christm45/shc-onstepx-remote/img/connections_front.png

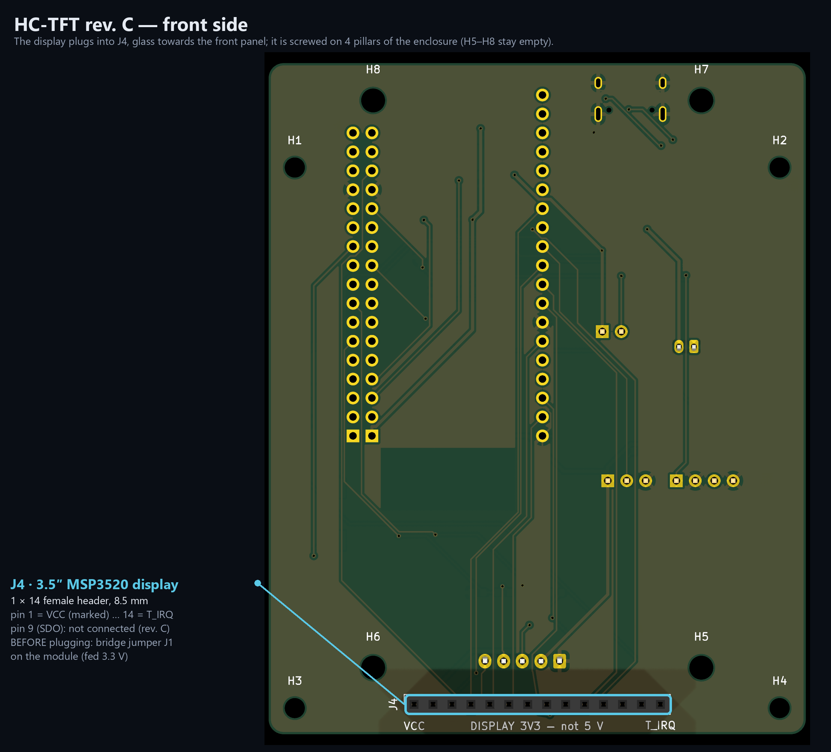
img/connections_front.png
