christm45/shc-onstepx-remote/img/enclosure/part_back_cover_inside.png

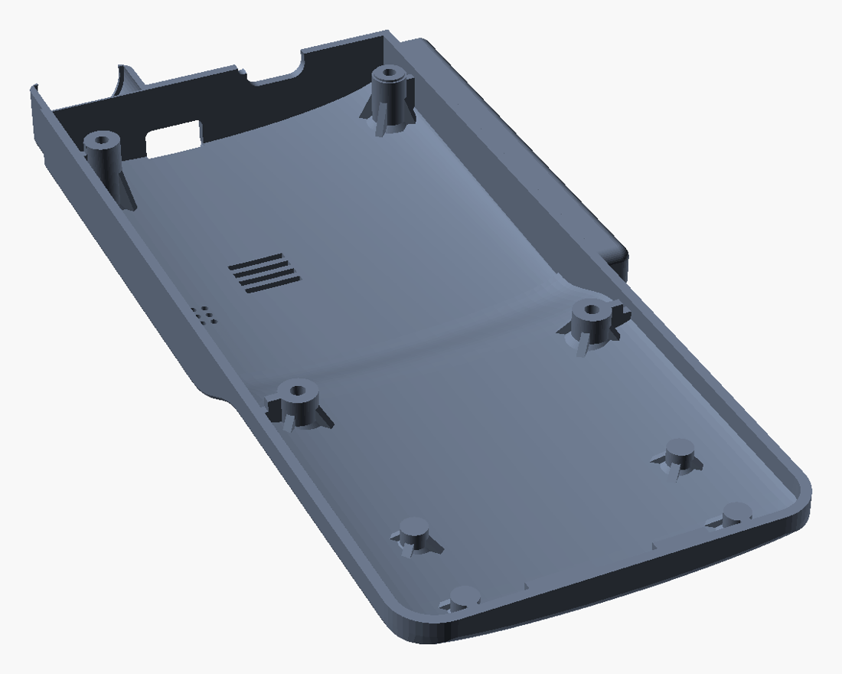
img/enclosure/part_back_cover_inside.png
