christm45/shc-onstepx-remote/img/enclosure/part_back_cover_outside.png

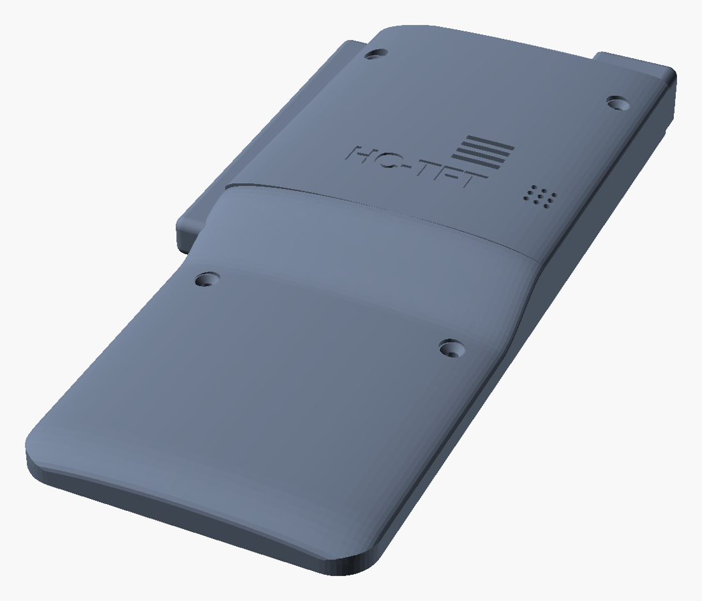
img/enclosure/part_back_cover_outside.png
