christm45/shc-onstepx-remote/img/enclosure/part_foot_pad_x2.png

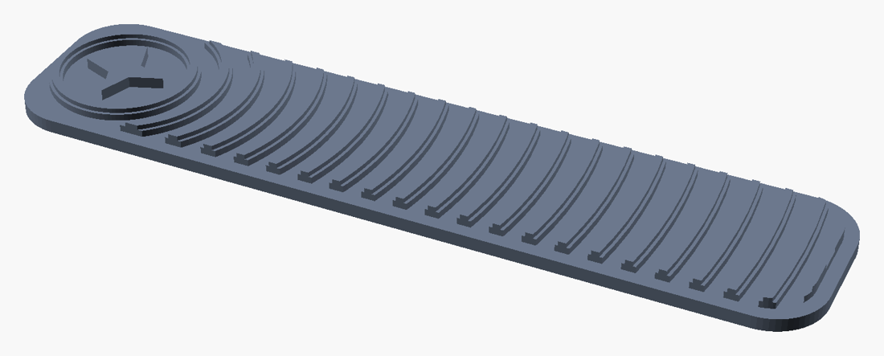
img/enclosure/part_foot_pad_x2.png
