christm45/shc-onstepx-remote/img/enclosure/part_front_inside.png

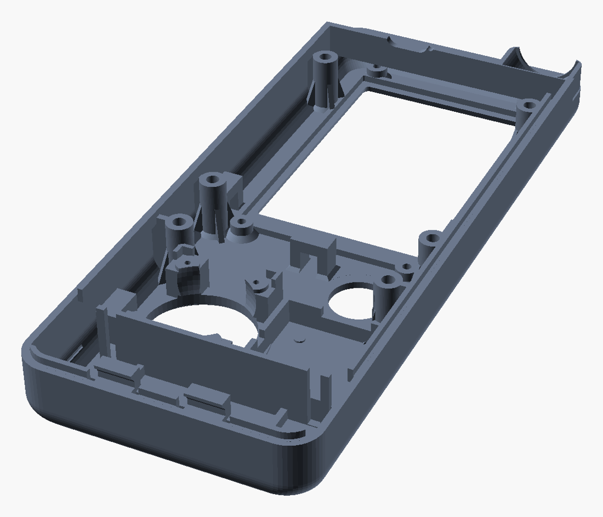
img/enclosure/part_front_inside.png
