christm45/shc-onstepx-remote/img/enclosure/part_front_outside.png

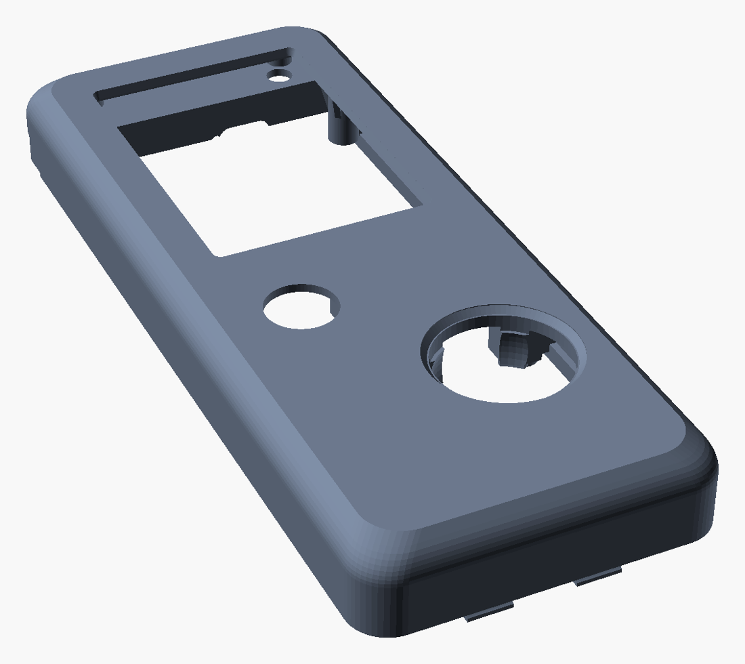
img/enclosure/part_front_outside.png
