christm45/shc-onstepx-remote/img/enclosure/part_joystick_cover.png

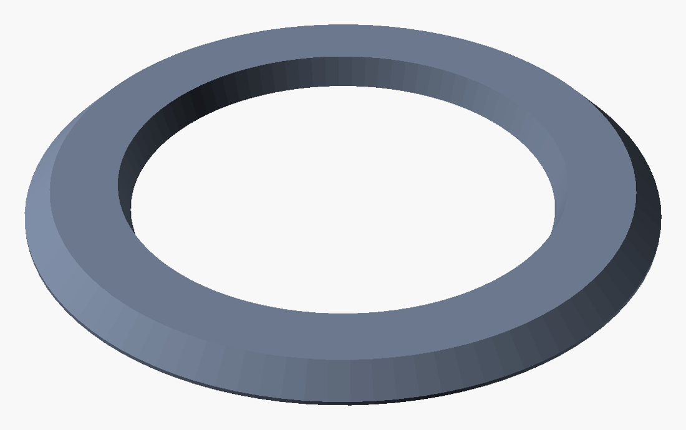
img/enclosure/part_joystick_cover.png
