christm45/shc-onstepx-remote/img/enclosure/part_joystick_template.png

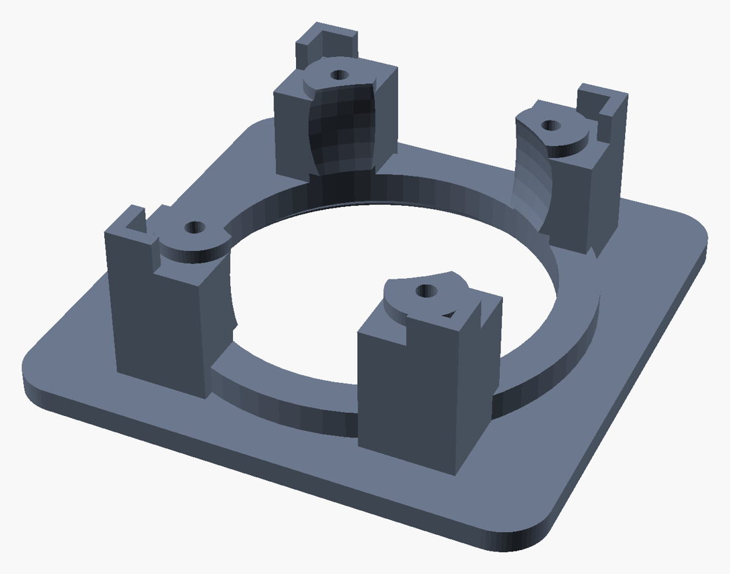
img/enclosure/part_joystick_template.png
