christm45/shc-onstepx-remote/img/pcb_smd_back.png

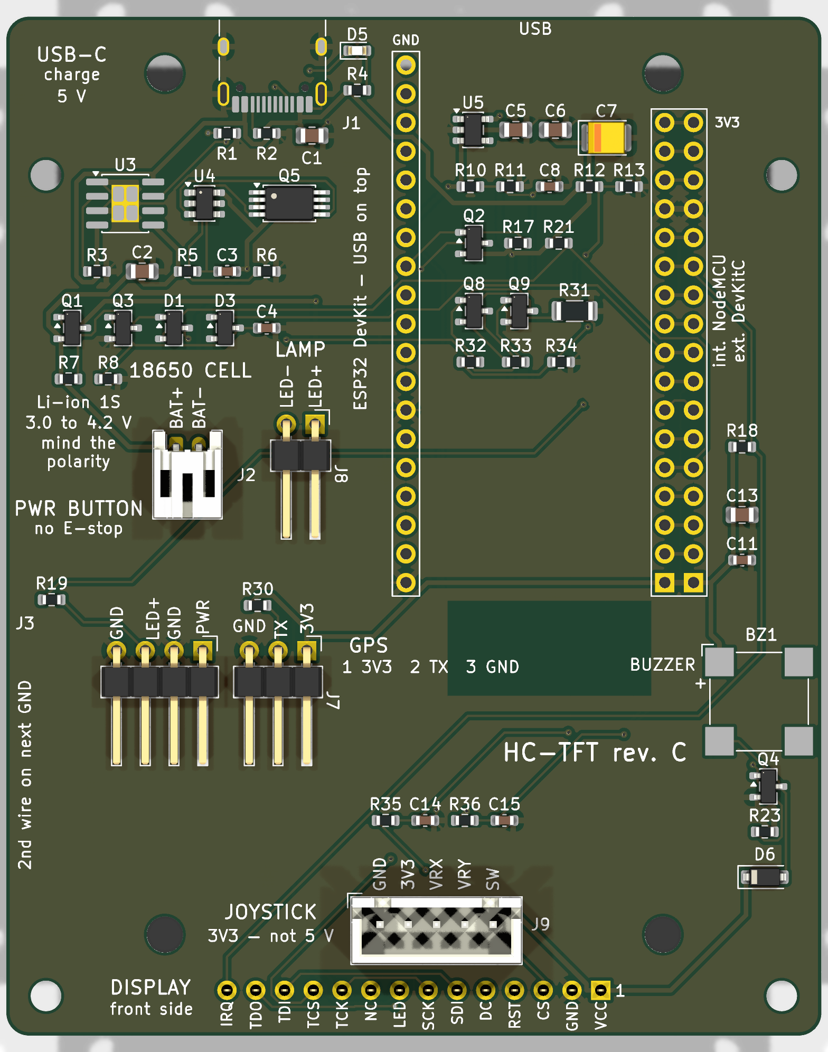
img/pcb_smd_back.png
