christm45/shc-onstepx-remote/img/pcb_smd_front.png

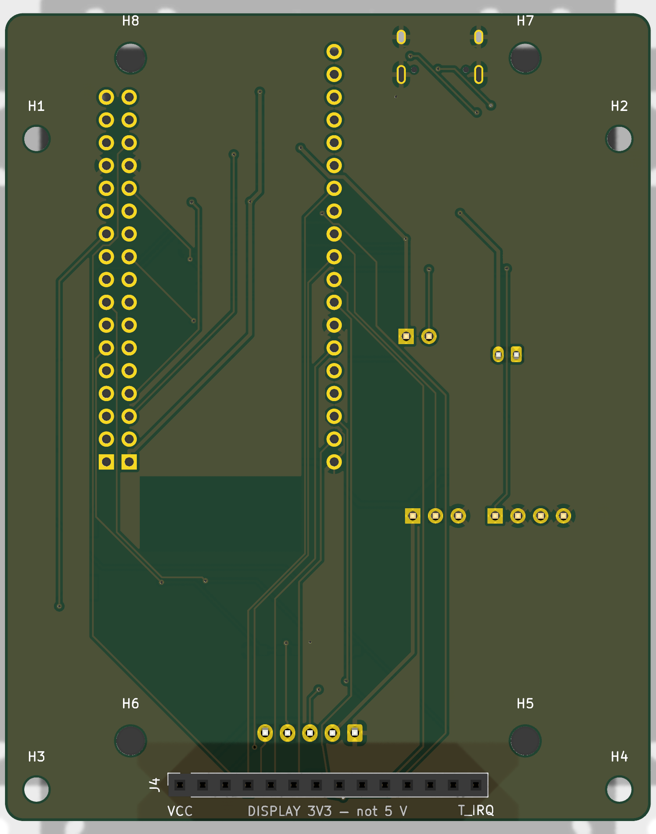
img/pcb_smd_front.png
