christm45/shc-onstepx-remote/img/pcb_tht_back.png

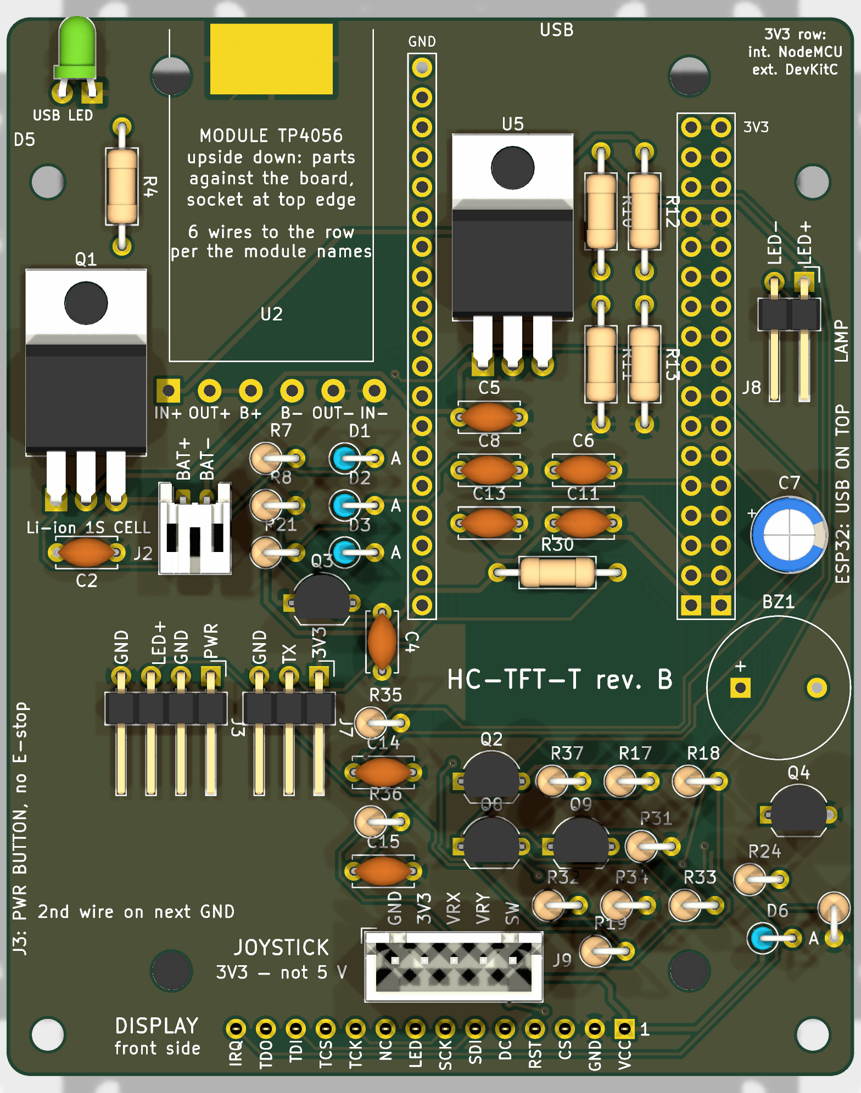
img/pcb_tht_back.png
