christm45/shc-onstepx-remote/img/pcb_tht_front.png

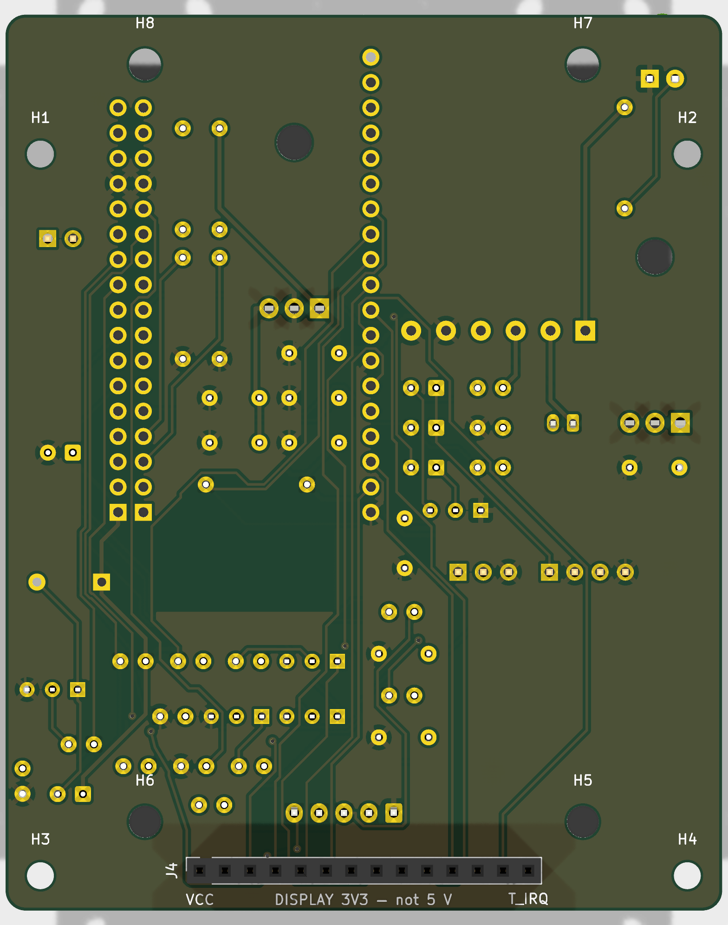
img/pcb_tht_front.png
