christm45/shc-onstepx-remote/img/stl_foot_pad_b.png

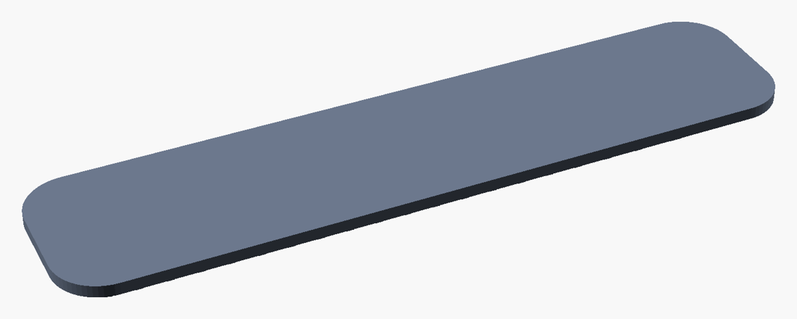
img/stl_foot_pad_b.png
