christm45/shc-onstepx-remote/img/stl_joystick_cover_b.png

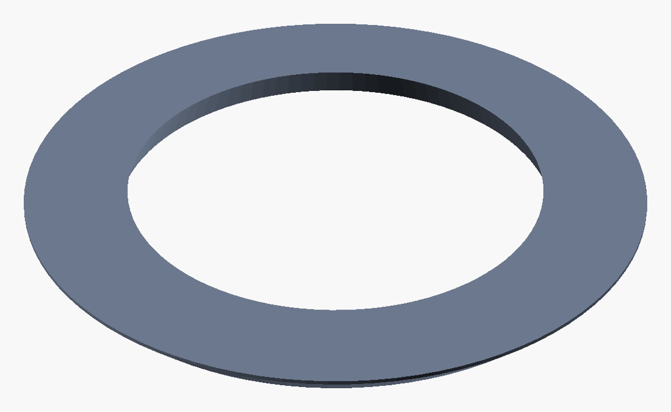
img/stl_joystick_cover_b.png
