christm45/shc-onstepx-remote/img/stl_joystick_template_b.png

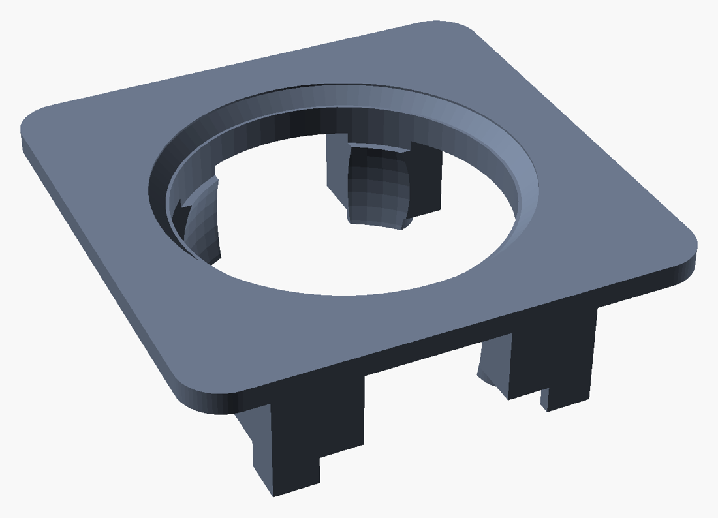
img/stl_joystick_template_b.png
