christm45/shc-onstepx-remote/downloads/pcb_smd_revC/HC-TFT_JLCPCB_BOM.csv

Comment | Designator | Footprint | LCSC Part #
10uF 25V X5R 0805 | C1,C2,C5,C6,C13 | 0805 | C15850
100nF 50V X7R 0603 | C3,C8,C11,C14,C15 | 0603 | C14663
4.7uF 16V X5R 0603 | C4 | 0603 | C19666
100uF 6.3V tantalum EIA-3528 | C7 | EIA-3528 (B) | C16133
BAT54C | D1,D3 | SOT-23 | C37704
red LED 0603 (2 mA) | D5 | 0603 | C2286
1N4148W | D6 | SOD-123 | C81598
USB-C receptacle 16 pins SMD | J1 | USB-C 16P SMD | C165948
AO3401A | Q1,Q2 | SOT-23 | C15127
2N7002 | Q3,Q4 | SOT-23 | C8545
FS8205A | Q5 | TSSOP-8 | C5148694
AO3400A | Q8 | SOT-23 | C20917
MMBT3904 | Q9 | SOT-23 | C20526
5.1kOhm 1% 0603 | R1,R2 | 0603 | C23186
10kOhm 5% 0603 | R17,R18,R21,R30,R34 | 0603 | C25804
150Ohm 5% 0603 | R19 | 0603 | C22808
1.2kOhm 1% 0603 | R3 | 0603 | C22765
3.9Ohm 5% 1206 0.25W | R31 | 1206 | C137280
4.7kOhm 5% 0603 | R32 | 0603 | C23162
1kOhm 5% 0603 | R4,R6,R33,R35,R36 | 0603 | C21190
100Ohm 5% 0603 | R5 | 0603 | C22775
100kOhm 5% 0603 | R7,R8,R10,R11,R12,R13,R23 | 0603 | C25803
TP4056 | U3 | SOIC-8-EP | C16581
DW01A | U4 | SOT-23-6 | C351410
AP2112K-3.3 | U5 | SOT-23-5 | C51118
