christm45/shc-onstepx-remote/downloads/stl/front.stl

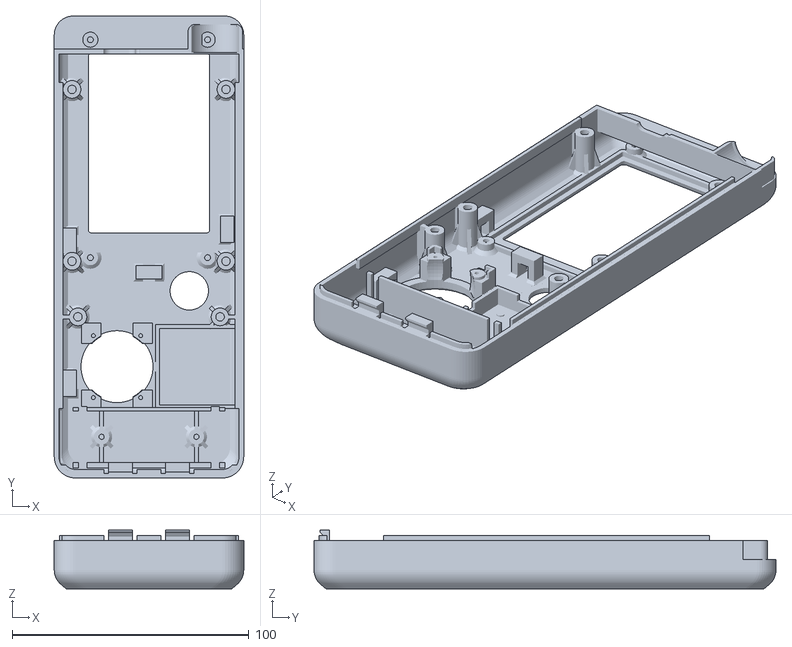
[picture p19: CAD file, 2026-11-04]
downloads/stl/front.stl
80.0 x 195.0 x 24.8
