christm45/shc-onstepx-remote/downloads/stl/foot_pad.stl

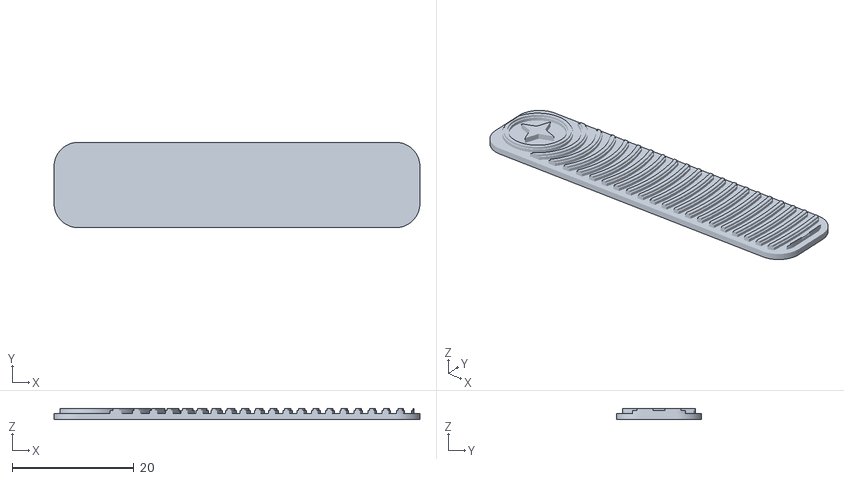
[picture p20: CAD file, 2026-11-04]
downloads/stl/foot_pad.stl
60.0 x 14.0 x 1.85
