christm45/shc-onstepx-remote/downloads/stl/tht/back_cover.stl

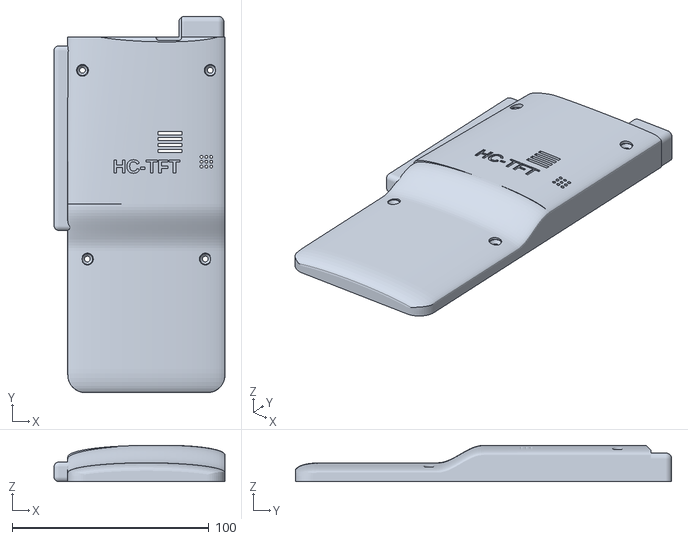
[picture p21: CAD file, 2026-11-04]
downloads/stl/tht/back_cover.stl
87.0 x 191.5 x 18.5
