christm45/shc-onstepx-remote/downloads/stl/joystick_cover.stl

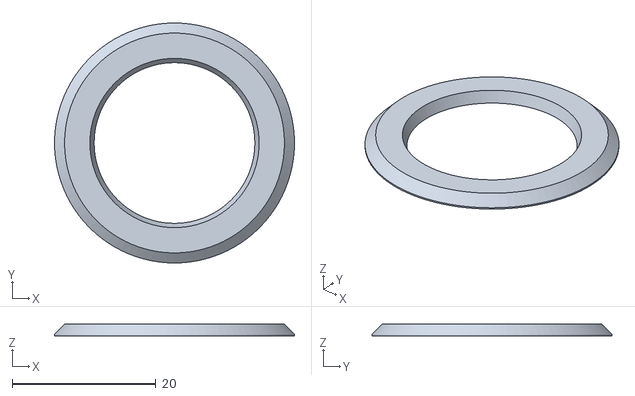
[picture p22: CAD file, 2026-11-04]
downloads/stl/joystick_cover.stl
33.4 x 33.4 x 1.60
