christm45/shc-onstepx-remote/downloads/stl/joystick_template.stl

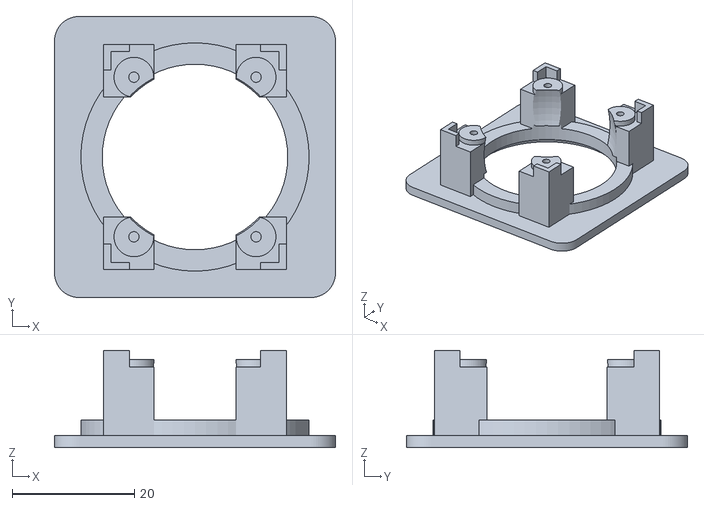
[picture p23: CAD file, 2026-11-04]
downloads/stl/joystick_template.stl
46.0 x 46.0 x 15.9
