christm45/shc-onstepx-remote/(list of files, cad)

Other CAD files:
downloads/stl/tht/front.stl
downloads/stl/back_cover.stl
