christm45/shc-onstepx-remote/img/enclosure/assembled_back_3-4.png

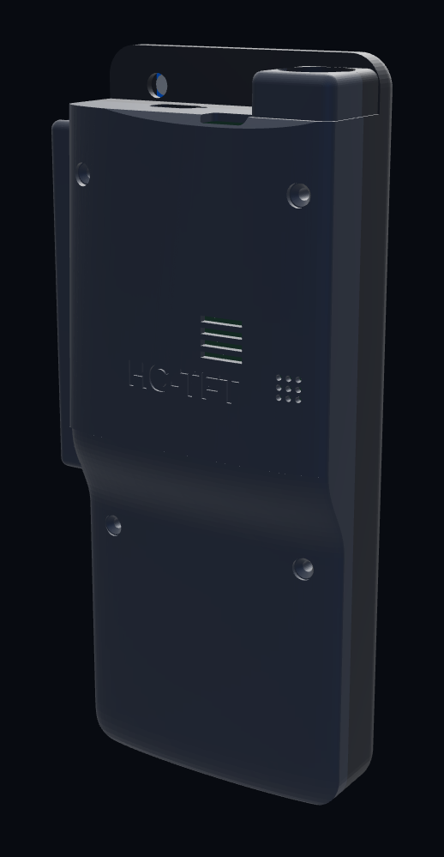
img/enclosure/assembled_back_3-4.png
