christm45/shc-onstepx-remote/img/enclosure/assembled_front.png

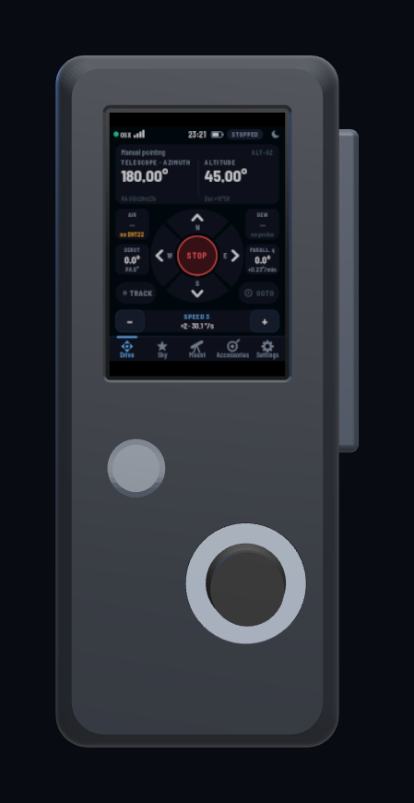
img/enclosure/assembled_front.png
