christm45/shc-onstepx-remote/img/enclosure/assembled_open_back_cover_removed.png

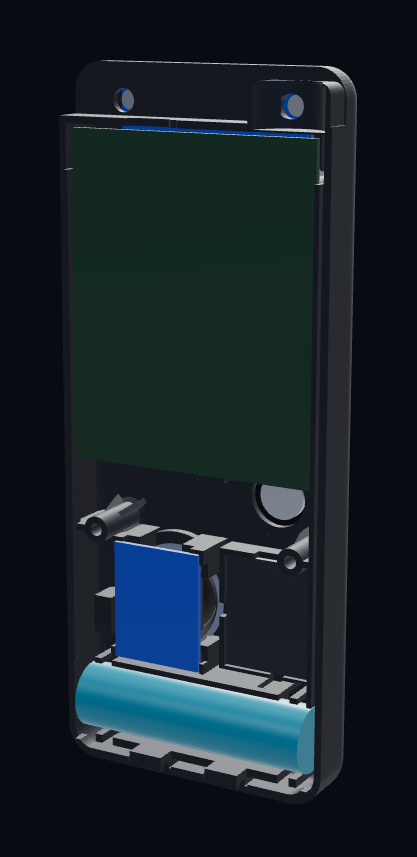
img/enclosure/assembled_open_back_cover_removed.png
