christm45/shc-onstepx-remote/img/enclosure/assembled_section.png

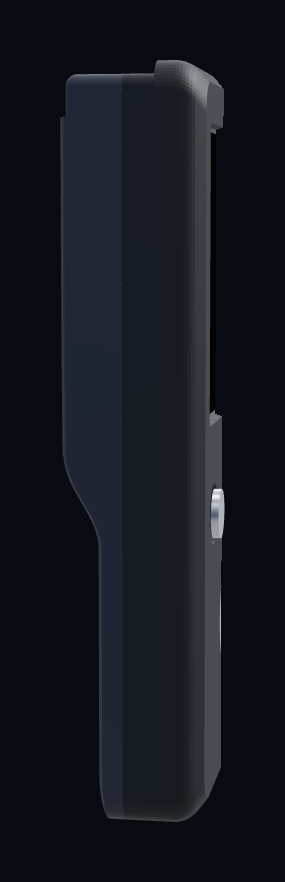
img/enclosure/assembled_section.png
