christm45/shc-onstepx-remote/(commit log)

2026-11-04 SHC OnStepX TFT hand controller: 3D page with live firmware, test bench, guide, wiring, pictures, JLCPCB files (HC-TFT rev. C, HC-TFT-T rev. B), STLs
    [HC-TFT-T_JLCPCB_BOM.csv, HC-TFT-T_hand_solder.csv, HC-TFT_JLCPCB_BOM.csv, HC-TFT_hand_solder.csv, back_cover.stl, foot_pad.stl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]
2026-11-04 Power button ABILKEEN 16 mm (red ring), 1 W deep red LED, joystick and GPS dimensions; front with a Ø 23 nut seat (collision test clean); shopping lists updated
    [front.stl]
2026-11-04 Up-to-date info: lit power button on J3 1-4 (image, page), clean public PARTS_LIST.md replacing the internal shopping lists, full README
2026-11-04 GPL-3.0 license (as OnStepX); enclosure pictures part by part and assembled
